hwstar/ISO-port/ch340-usb-serial-isolated.pdf

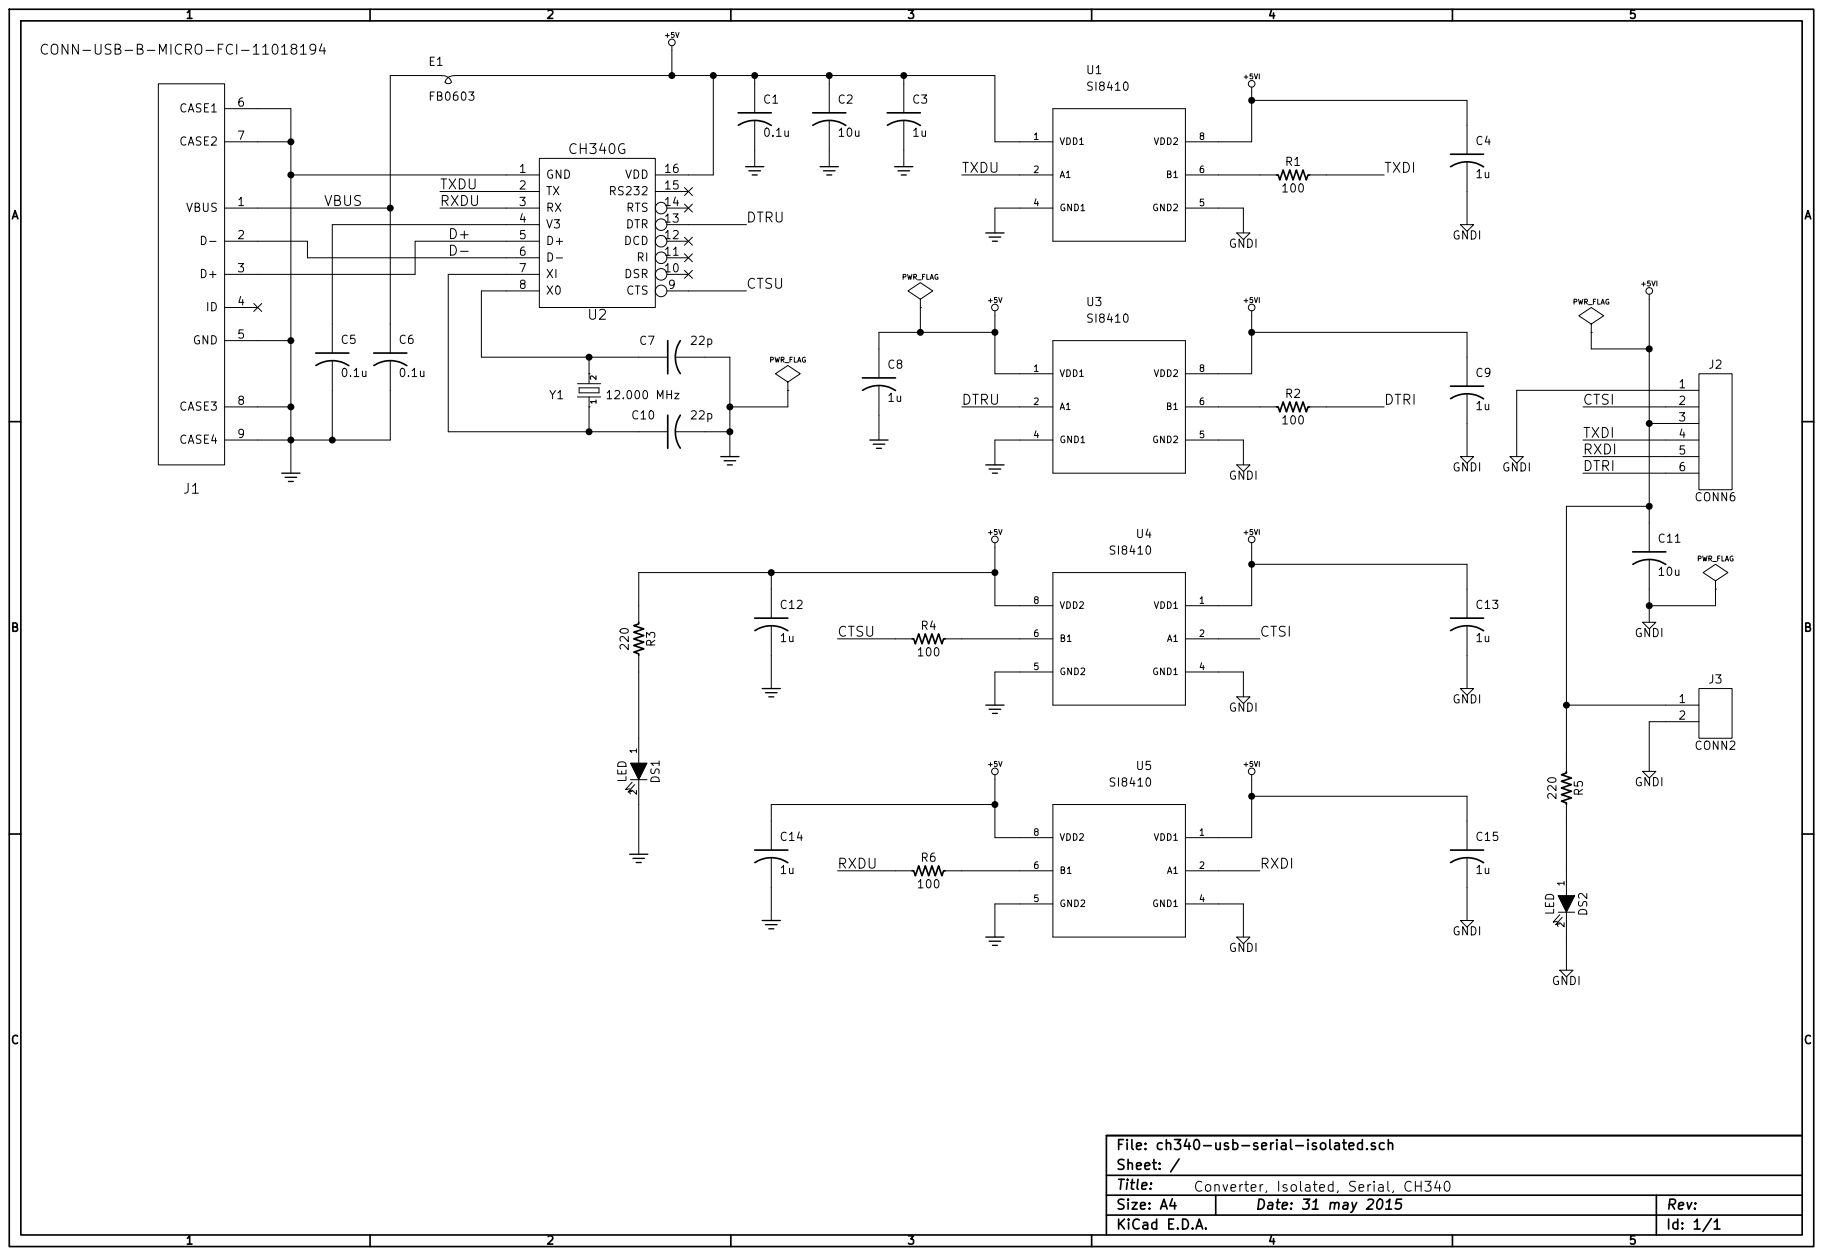
[picture p3: page 1]

TXDI DTRI CTSI RXDI GNDI GNDI GNDI GNDI
