hwstar/ISO-port/ch340-usb-serial-isolated.kicad_pcb

## KiCad design ch340-usb-serial-isolated.kicad_pcb (2015-06-24)

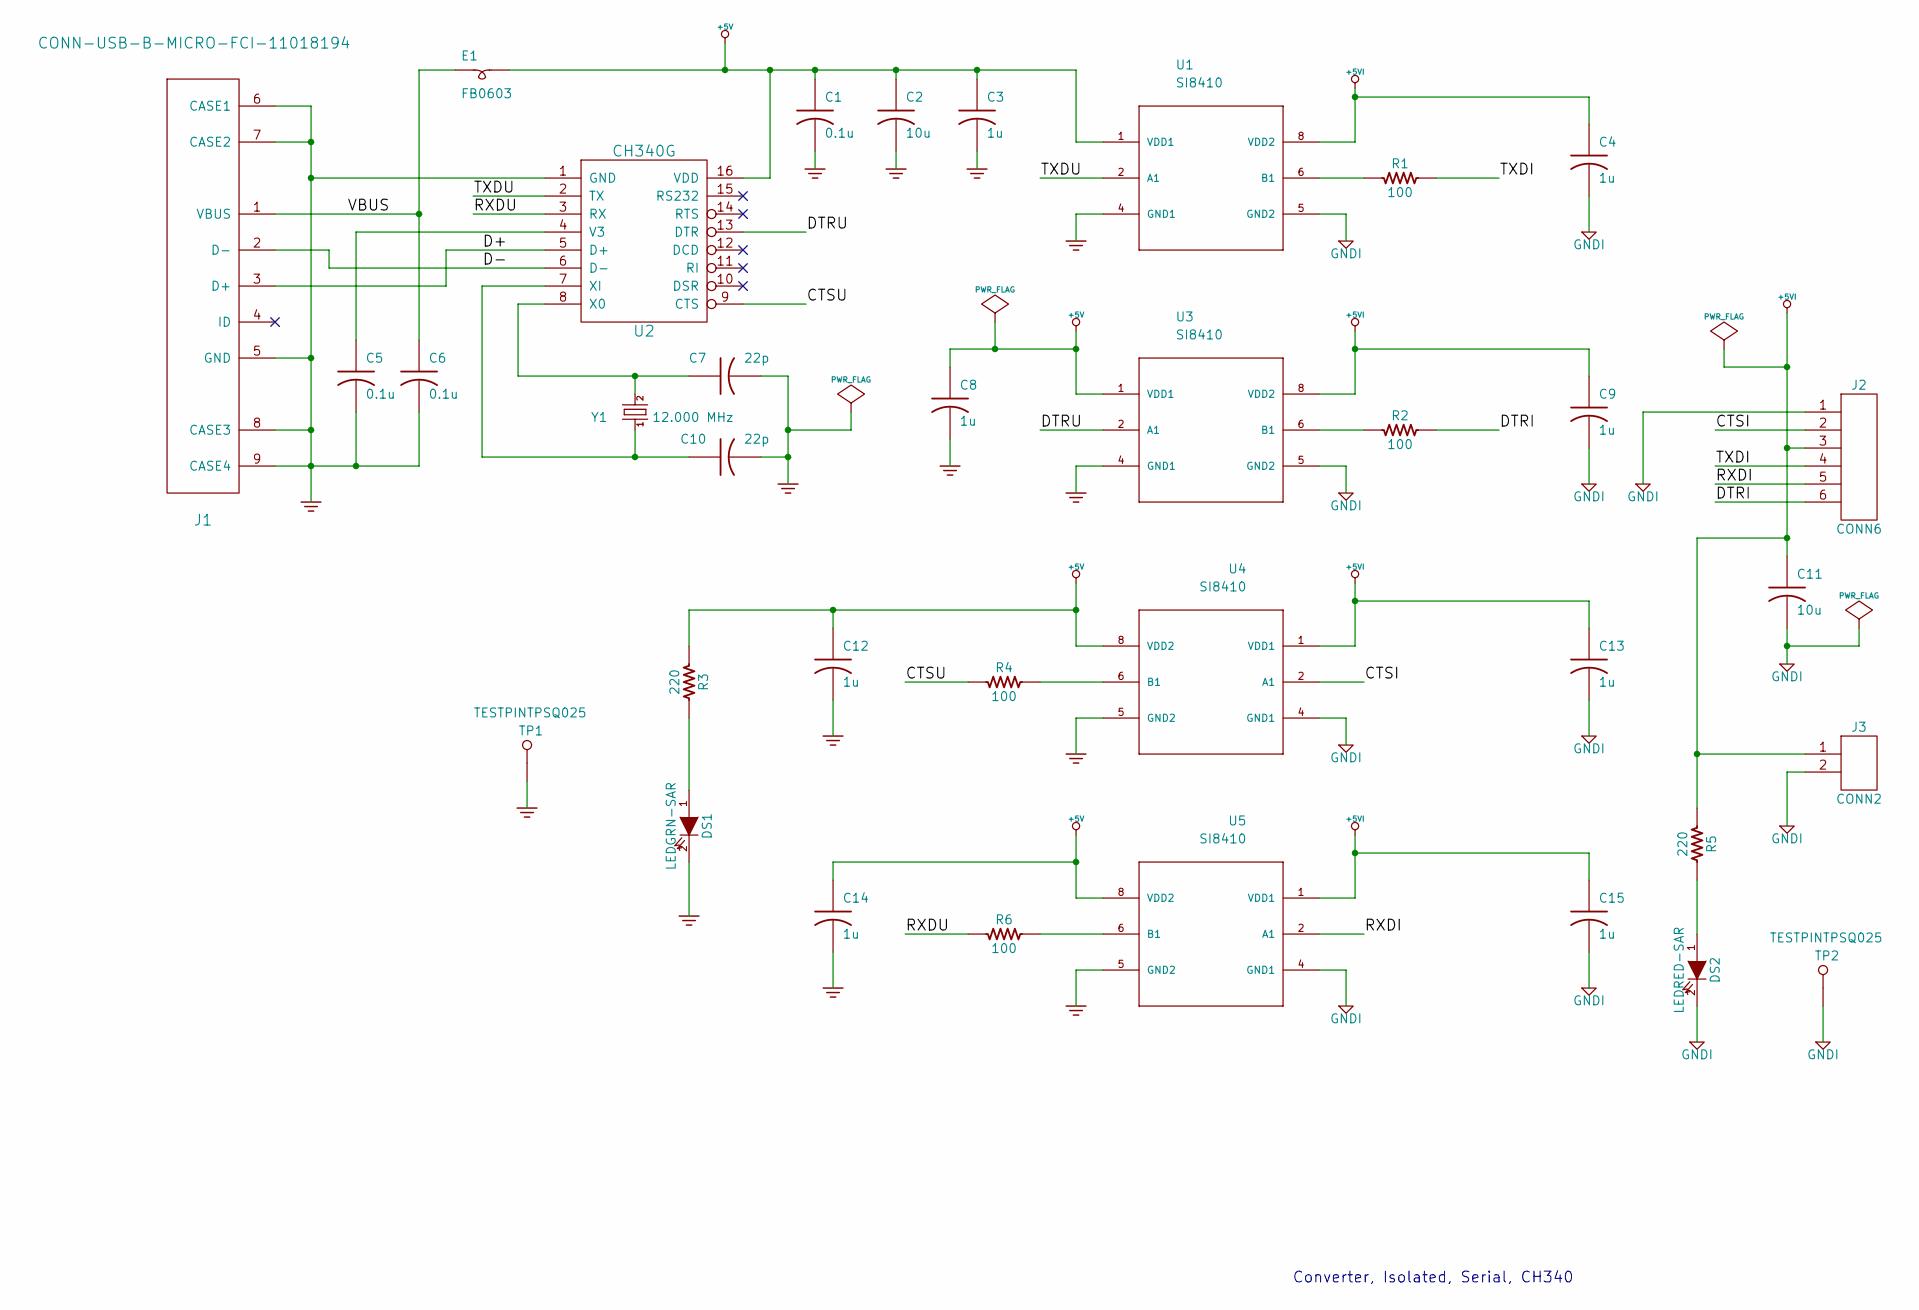
[picture p4: schematic ch340-usb-serial-isolated.sch]

Parts:
C1, C5, C6: 0.1u; CC0603; PartNumber 800000-104
C2, C11: 10u; CC0805; PartNumber 800003-106
C3, C4, C8, C9, C12, C13, C14, C15: 1u; CC0603; PartNumber 800001-105
C7, C10: 22p; CC0603; PartNumber 800002-220
DS1: LEDGRN-SAR; LED0805; PartNumber 800113-102
DS2: LEDRED-SAR; LED-SAR; PartNumber 800113-101
E1: FB0603; 0603; PartNumber 800040-600
J1: CONN-USB-B-MICRO-FCI-11018194; PartNumber 800118-101
J2: CONN6; PartNumber 800114-106
J3: CONN2; PartNumber 800114-102
R1, R2, R4, R6: 100; RC0603; PartNumber 800010-101
R3, R5: 220; RC0805; PartNumber 800011-221
TP1, TP2: TESTPINTPSQ025; TESTPIN
U1, U3, U4, U5: SI8410; S08; PartNumber 800119-101
U2: CH340G; PartNumber 800102-101
Y1: 12.000 MHz; HC49US; PartNumber 800108-012

Connections:
+5V: C1.1, C2.1, C3.1, C8.1, C12.1, C14.1, E1.2, R3.1, U1.1 (VDD1), U2.16 (VDD), U3.1 (VDD1), U4.8 (VDD2), U5.8 (VDD2)
+5VI: C4.1, C9.1, C11.1, C13.1, C15.1, J2.3, J3.1, R5.1, U1.8 (VDD2), U3.8 (VDD2), U4.1 (VDD1), U5.1 (VDD1)
/CTSI: J2.2, U4.2 (A1)
/CTSU: R4.1, U2.9 (CTS)
/D+: J1.3 (D+), U2.5 (D+)
/D-: J1.2 (D-), U2.6 (D-)
/DTRI: J2.6, R2.2
/DTRU: U2.13 (DTR), U3.2 (A1)
/RXDI: J2.5, U5.2 (A1)
/RXDU: R6.1, U2.3 (RX)
/TXDI: J2.4, R1.2
/TXDU: U1.2 (A1), U2.2 (TX)
/VBUS: C6.1, E1.1, J1.1 (VBUS)
GND: C1.2, C2.2, C3.2, C5.2, C6.2, C7.2, C8.2, C10.2, C12.2, C14.2, DS1.2 (K), J1.5 (GND), J1.6 (CASE1), J1.7 (CASE2), J1.8 (CASE3), J1.9 (CASE4), TP1.1, U1.4 (GND1), U2.1 (GND), U3.4 (GND1), U4.5 (GND2), U5.5 (GND2)
GNDI: C4.2, C9.2, C11.2, C13.2, C15.2, DS2.2 (K), J2.1, J3.2, TP2.1, U1.5 (GND2), U3.5 (GND2), U4.4 (GND1), U5.4 (GND1)
unnamed: R1.1, U1.6 (B1)
unnamed: R6.2, U5.6 (B1)
unnamed: DS2.1 (A), R5.2
unnamed: DS1.1 (A), R3.2
unnamed: R2.1, U3.6 (B1)
unnamed: R4.2, U4.6 (B1)
unnamed: C10.1, U2.7 (XI), Y1.1
unnamed: C5.1, U2.4 (V3)
unnamed: C7.1, U2.8 (X0), Y1.2

Notes on the sheet:
Converter, Isolated, Serial, CH340

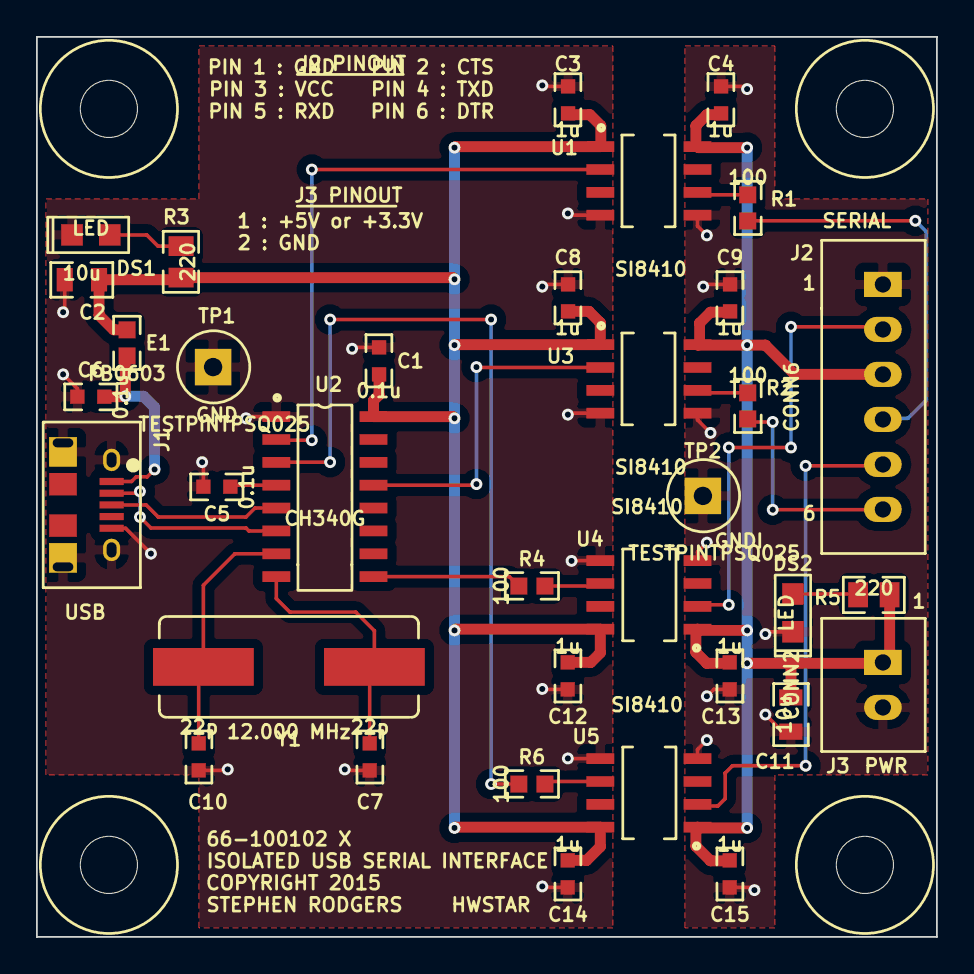
[picture p5: board ch340-usb-serial-isolated.kicad_pcb from above]

Board: 2 copper layers, 50.0 x 50.0 mm, 39 parts (0 on the bottom side), 24 nets.

Other parts of the board:
MTG-HOLE-125-RING-300, MTG-HOLE-125-RING-300#2, MTG-HOLE-125-RING-300#3, MTG-HOLE-125-RING-300#4: VAL**; MTG-HOLE-125-RING-300
