hwstar/ISO-port/(commit log)

2015-06-24 Initial Checkin
    [ch340-usb-serial-isolated.csv, ch340-usb-serial-isolated.kicad_pcb, ch340-usb-serial-isolated.sch]
2015-09-21 Boards on Tindie removed as there is no more stock
