hwstar/ISO-port/(notices)

Notices in the files:
ch340-usb-serial-isolated.kicad_pcb:
COPYRIGHT 2015
